PhilDaviesAust/Scoreboard-cricket-neopixel/README.md

### Scoreboard-cricket-neopixel
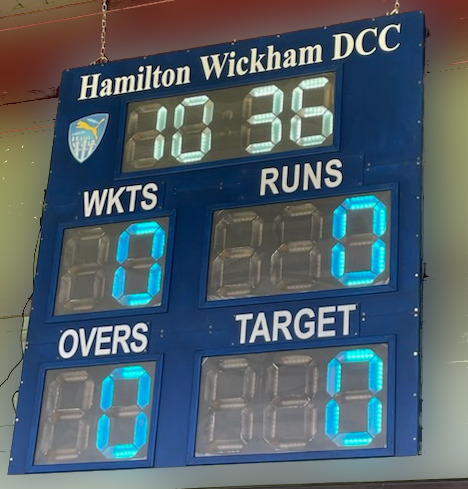
[picture p1: scoreboard.jpg]
Scoreboard
  

Cricket Scoreboard project using:

Hardware:
- ESP12 (Wemos D1 mini) module
- WS2812B/WS2815 addressable LED strip
