PhilDaviesAust/Scoreboard-cricket-neopixel/CADDFiles/TinyCAD-VeeCADD/fastLED-ESP8266-Board.png

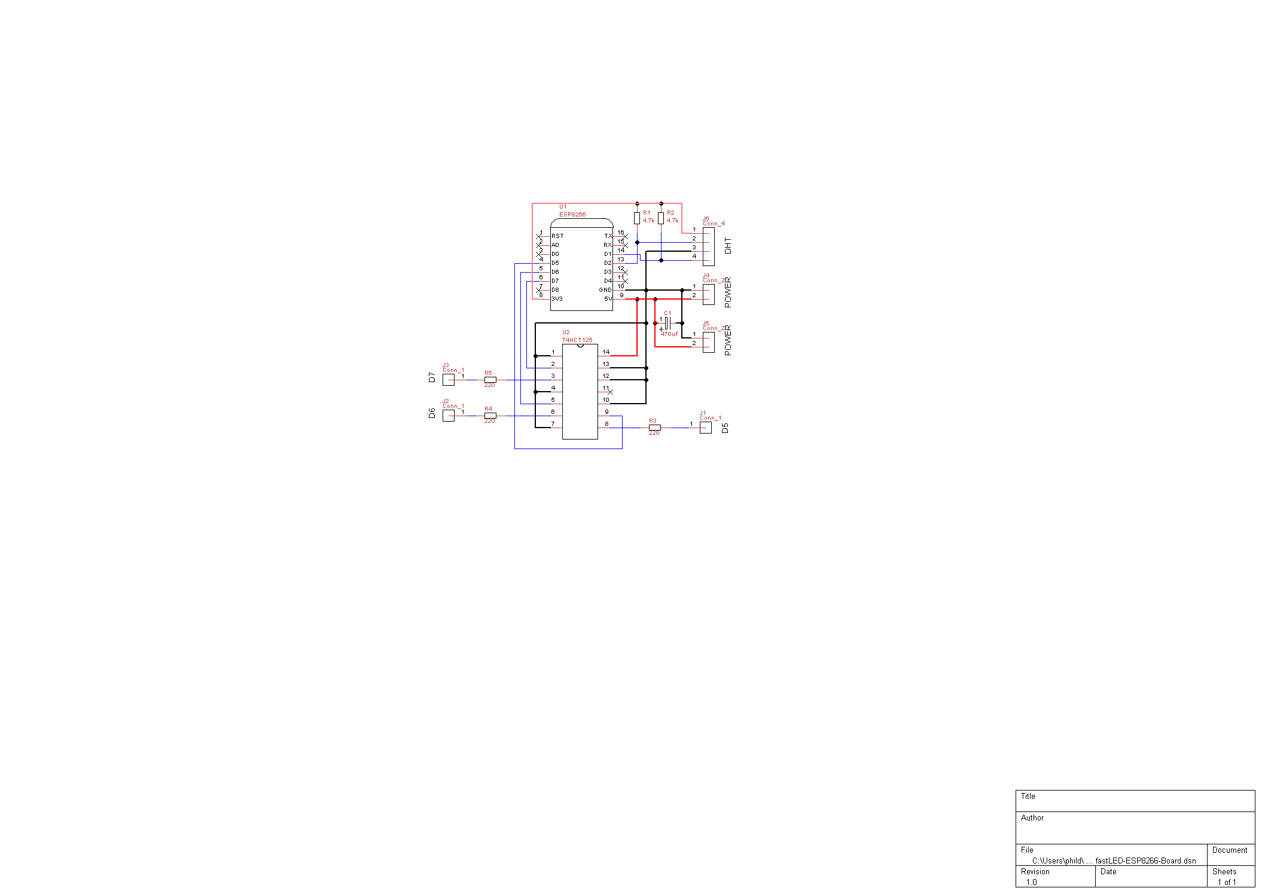
CADDFiles/TinyCAD-VeeCADD/fastLED-ESP8266-Board.png
