PhilDaviesAust/Scoreboard-cricket-neopixel/datasheets/esp01-pinout.png

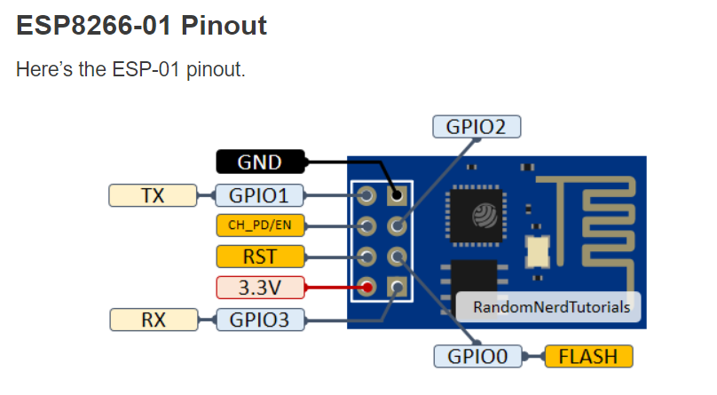
datasheets/esp01-pinout.png
