PhilDaviesAust/Scoreboard-cricket-neopixel/(list of files, drawings)

Other design files:
CADDFiles/TinyCAD-VeeCADD/fastLED-ESP8266-Board.dsn
