PhilDaviesAust/Scoreboard-cricket-neopixel/CADDFiles/WiringLayout.pdf

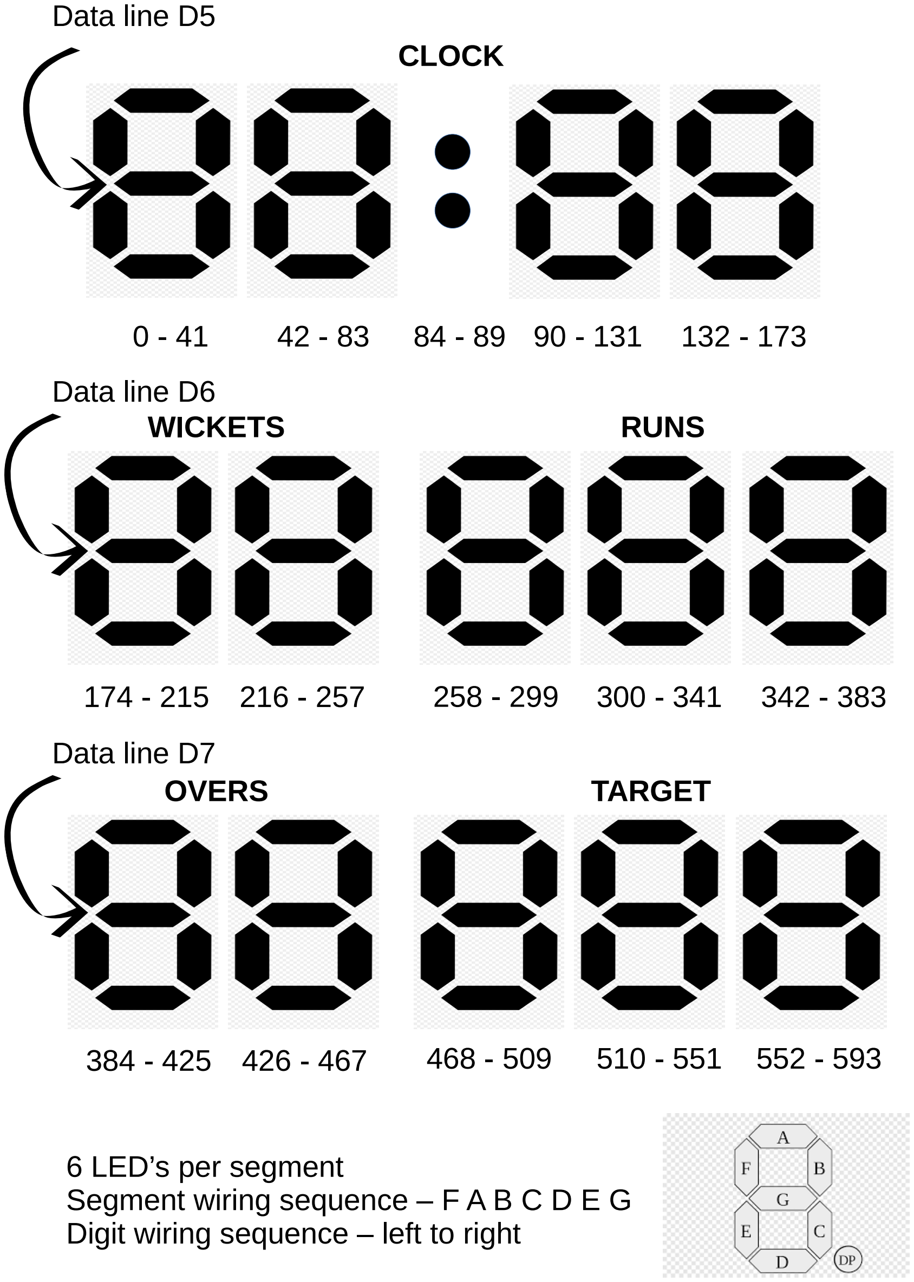
[picture p4: page 1]

CLOCK

WICKETS | RUNS
OVERS | TARGET
0 - 41 | 42 - 83 | 90 - 131 132 - 173

174 - 215 216 - 257

384 - 425 426 - 467

258 - 299 300 - 341 342 - 383

468 - 509 510 - 551 552 - 593

84 - 89

6 LED’s per segment
Segment wiring sequence – F A B C D E G Digit wiring sequence – left to right

Data line D5

Data line D6

Data line D7
