PhilDaviesAust/Scoreboard-cricket-neopixel/(commit log)

2021-12-19 mapping arrays added
    [Digit2LEDmapping.csv, Digit2LEDmapping.ods]
2021-12-19 updateLEDs function added
    [Digit2LEDmapping.ods]
2021-12-27 time update added
    [Digit2LEDmapping.csv, Digit2LEDmapping.ods]
2022-01-01 refactored [leds] update functions
2022-01-01 24 hour time bug corrected
    [main.cpp]
2022-01-02 segment mapping array reordered to suit wiring
    [Digit2LEDmapping.csv, Digit2LEDmapping.ods]
2022-01-11 ESP01 datasheet added
    [Digit2LEDmapping.ods]
2022-03-20 remap leds to suit wiring
2022-03-21 added wiring layout sketch
2022-03-21 remap character buffer to match wiring
2022-08-09 Add temperature function
2022-09-27 LED startup added
2022-09-30 LEDStartup bug fix
2022-10-31 Clock pulse bug fixed
    [main.cpp, varDeclaration.h]
2023-02-20 testing possibe clock errors
    [main.cpp, varDeclaration.h]
2023-02-27 organise files for publication
    [Digit2LEDmapping.csv, Digit2LEDmapping.ods, fastLED-ESP8266-Board.dsn]
2023-03-07 add more documentation
    [Digit2LEDmapping.csv, Digit2LEDmapping.ods]
2023-03-07 LED voltage changed to 5V
2023-03-25 CADD files zipped
    [fastLED-ESP8266-Board.dsn]
